kc9mne/esp32-Wi-F0X/hardware/renders/angle.png

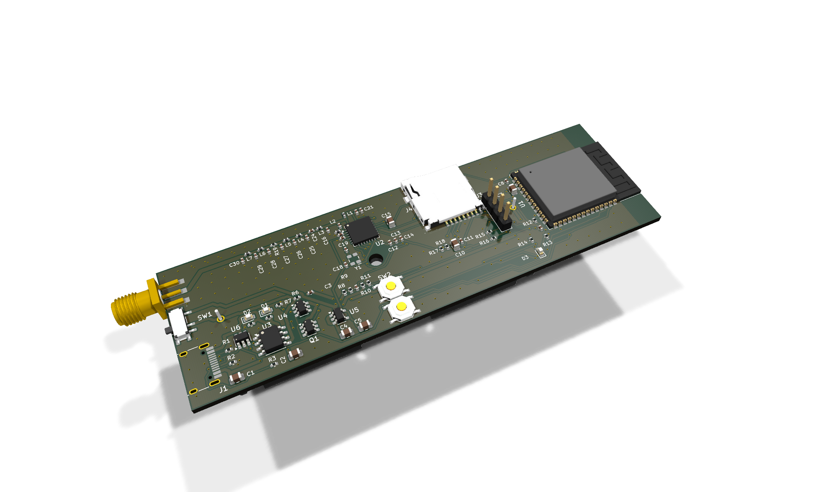
hardware/renders/angle.png
