kc9mne/esp32-Wi-F0X/hardware/renders/bottom.png

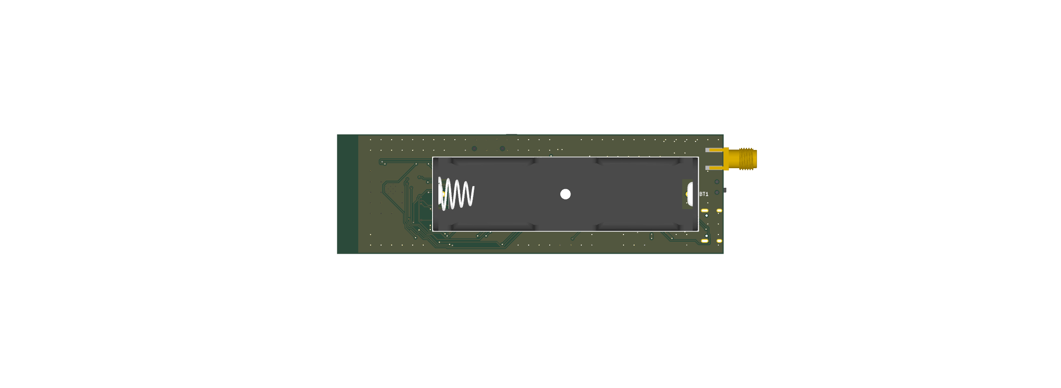
hardware/renders/bottom.png
