kc9mne/esp32-Wi-F0X/hardware/renders/copper.png

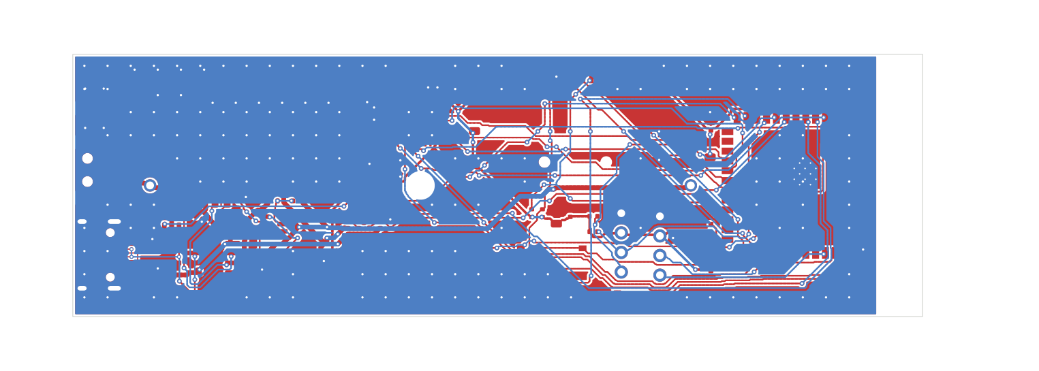
hardware/renders/copper.png
