kc9mne/esp32-Wi-F0X/hardware/renders/top.png

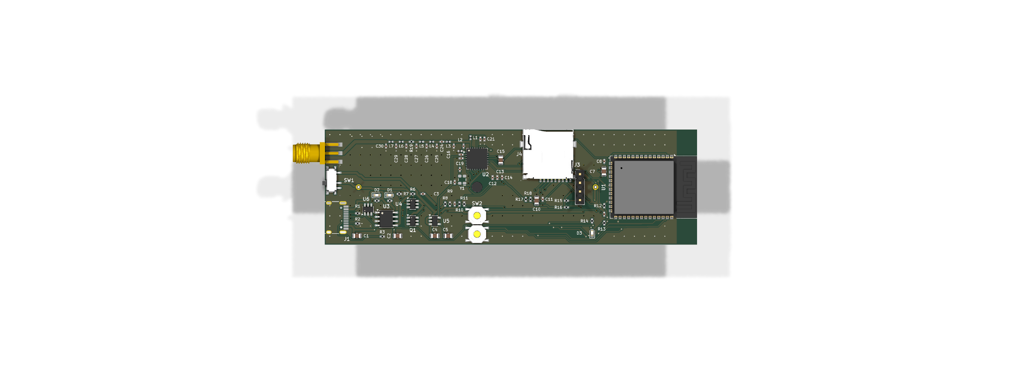
hardware/renders/top.png
