kc9mne/esp32-Wi-F0X/hardware/fox_bom_jlc.csv

Comment | Designator | Footprint | LCSC Part #
18650 | BT1 | BAT-TH_BH-18650-A1AJ005 | C49118395
10uF | C1,C2,C4,C5,C10,C15 | C_0805_2012Metric | C15850
10nF | C19,C21 | C_0402_1005Metric | C15195
270pF | C20,C24 | C_0402_1005Metric | C161546
18pF | C22 | C_0402_1005Metric | C1549
6.8pF | C23 | C_0402_1005Metric | C1576
39pF | C25,C26,C29 | C_0402_1005Metric | C1864552
9.1pF | C27 | C_0402_1005Metric | C64366
22pF | C28,C30 | C_0402_1005Metric | C1555
100nF | C3,C6,C8,C11,C12,C13,C14,C16,C17,C18 | C_0402_1005Metric | C1525
22uF | C7 | C_0805_2012Metric | C45783
1uF | C9 | C_0402_1005Metric | C52923
green: charged | D1 | LED_0603_1608Metric | C965804
red: charging | D2 | LED_0603_1608Metric | C2286
blue: status | D3 | LED_0603_1608Metric | C965807
USB-C | J1 | USB_C_Receptacle_HRO_TYPE-C-31-M-12 | C165948
microSD | J4 | TF-SMD_TF-01A | C91145
120nH | L1 | L_0402_1005Metric | C113123
91nH | L2 | L_0402_1005Metric | C113121
68nH | L3,L6,L7 | L_0402_1005Metric | C108965
56nH | L4 | L_0402_1005Metric | C167482
39nH | L5 | L_0402_1005Metric | C98059
FS8205A | Q1 | SOT-23-6 | C2830320
5.1k | R1,R2 | R_0402_1005Metric | C25905
10k | R12,R13,R17,R18 | R_0402_1005Metric | C25744
4.7k | R15,R16 | R_0402_1005Metric | C25900
0 | R19 | R_0402_1005Metric | C17168
2.4k | R3 | R_0402_1005Metric | C25882
1k | R4,R5,R7,R14 | R_0402_1005Metric | C11702
100 | R6 | R_0402_1005Metric | C25076
100k | R8,R9,R10,R11 | R_0402_1005Metric | C25741
POWER | SW1 | SW-TH_MSK12C02 | C431540
RESET/BOOT | SW2,SW3 | SW-SMD_4P-L5.1-W5.1-P3.70-LS6.5-TL_H1.5 | C318884
ESP32-S3-WROOM-1-N8 | U1 | ESP32-S3-WROOM-1 | C2913198
SX1278IMLTRT | U2 | QFN-28-1EP_6x6mm_P0.65mm_EP4.8x4.8mm | C67678
TP4056 | U3 | SOIC-8-1EP_3.9x4.9mm_P1.27mm_EP2.29x3mm | C16581
DW01A | U4 | SOT-23-6 | C351410
ME6211C33 | U5 | SOT-23-5 | C82942
USBLC6-2SC6 | U6 | SOT-23-6 | C7519
TG2520SMN 32MHz | Y1 | Oscillator_SMD_SeikoEpson_TG2520SMN-xxx-xxxxxx-4Pin_2.5x2.0mm | C3007516
