kc9mne/esp32-Wi-F0X/hardware/fox.pdf

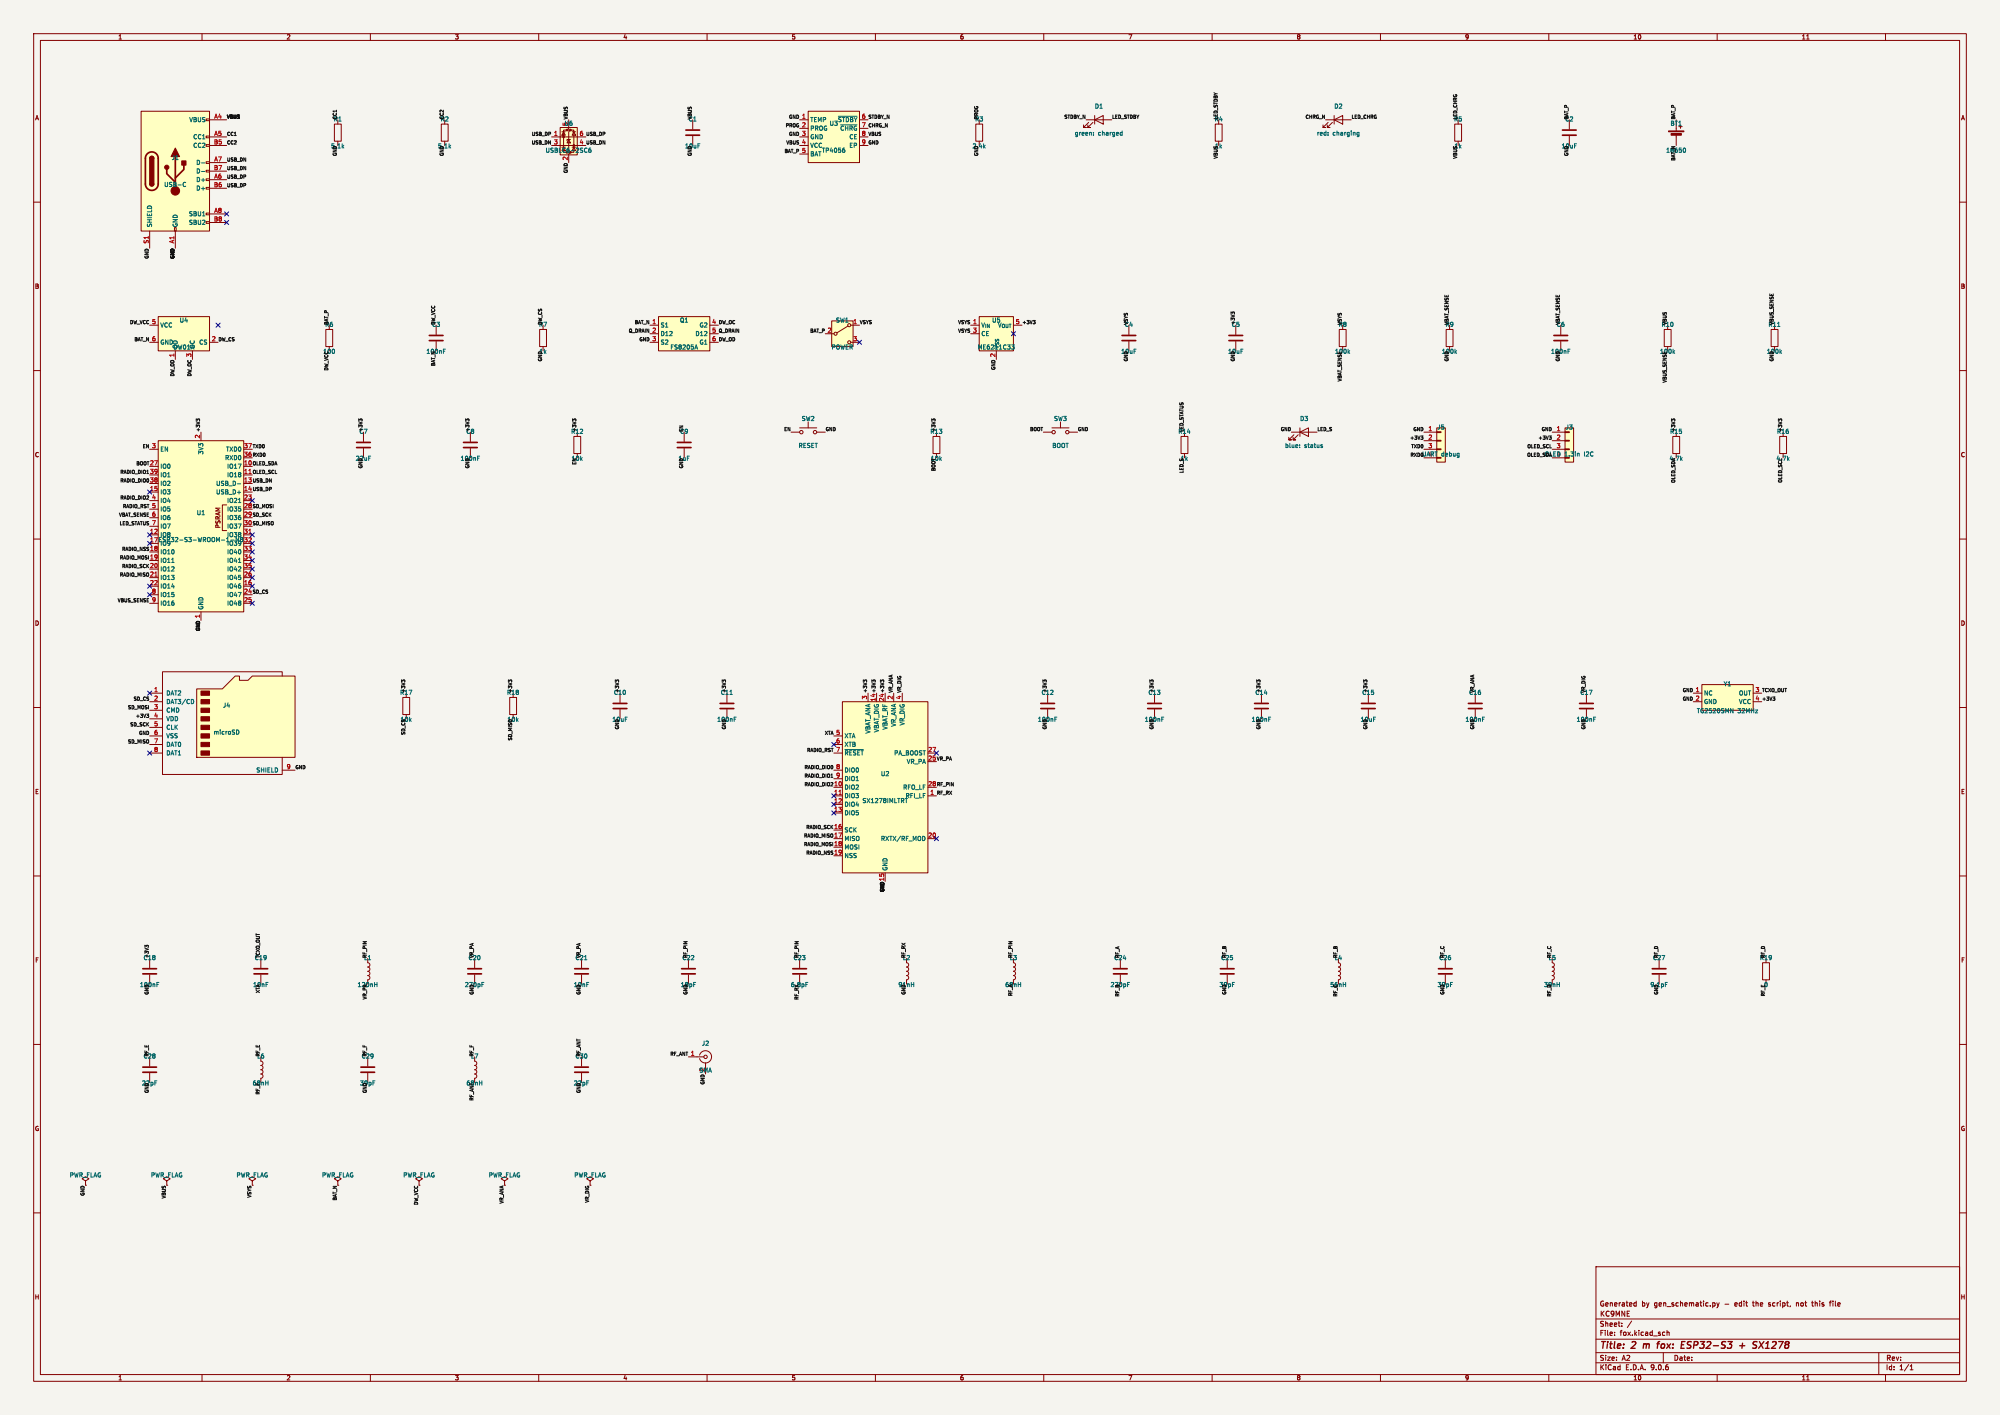
[picture p6: page 1]
