kc9mne/esp32-Wi-F0X/hardware/fox.kicad_pcb

## KiCad design hardware/fox.kicad_pcb (2026-11-11)

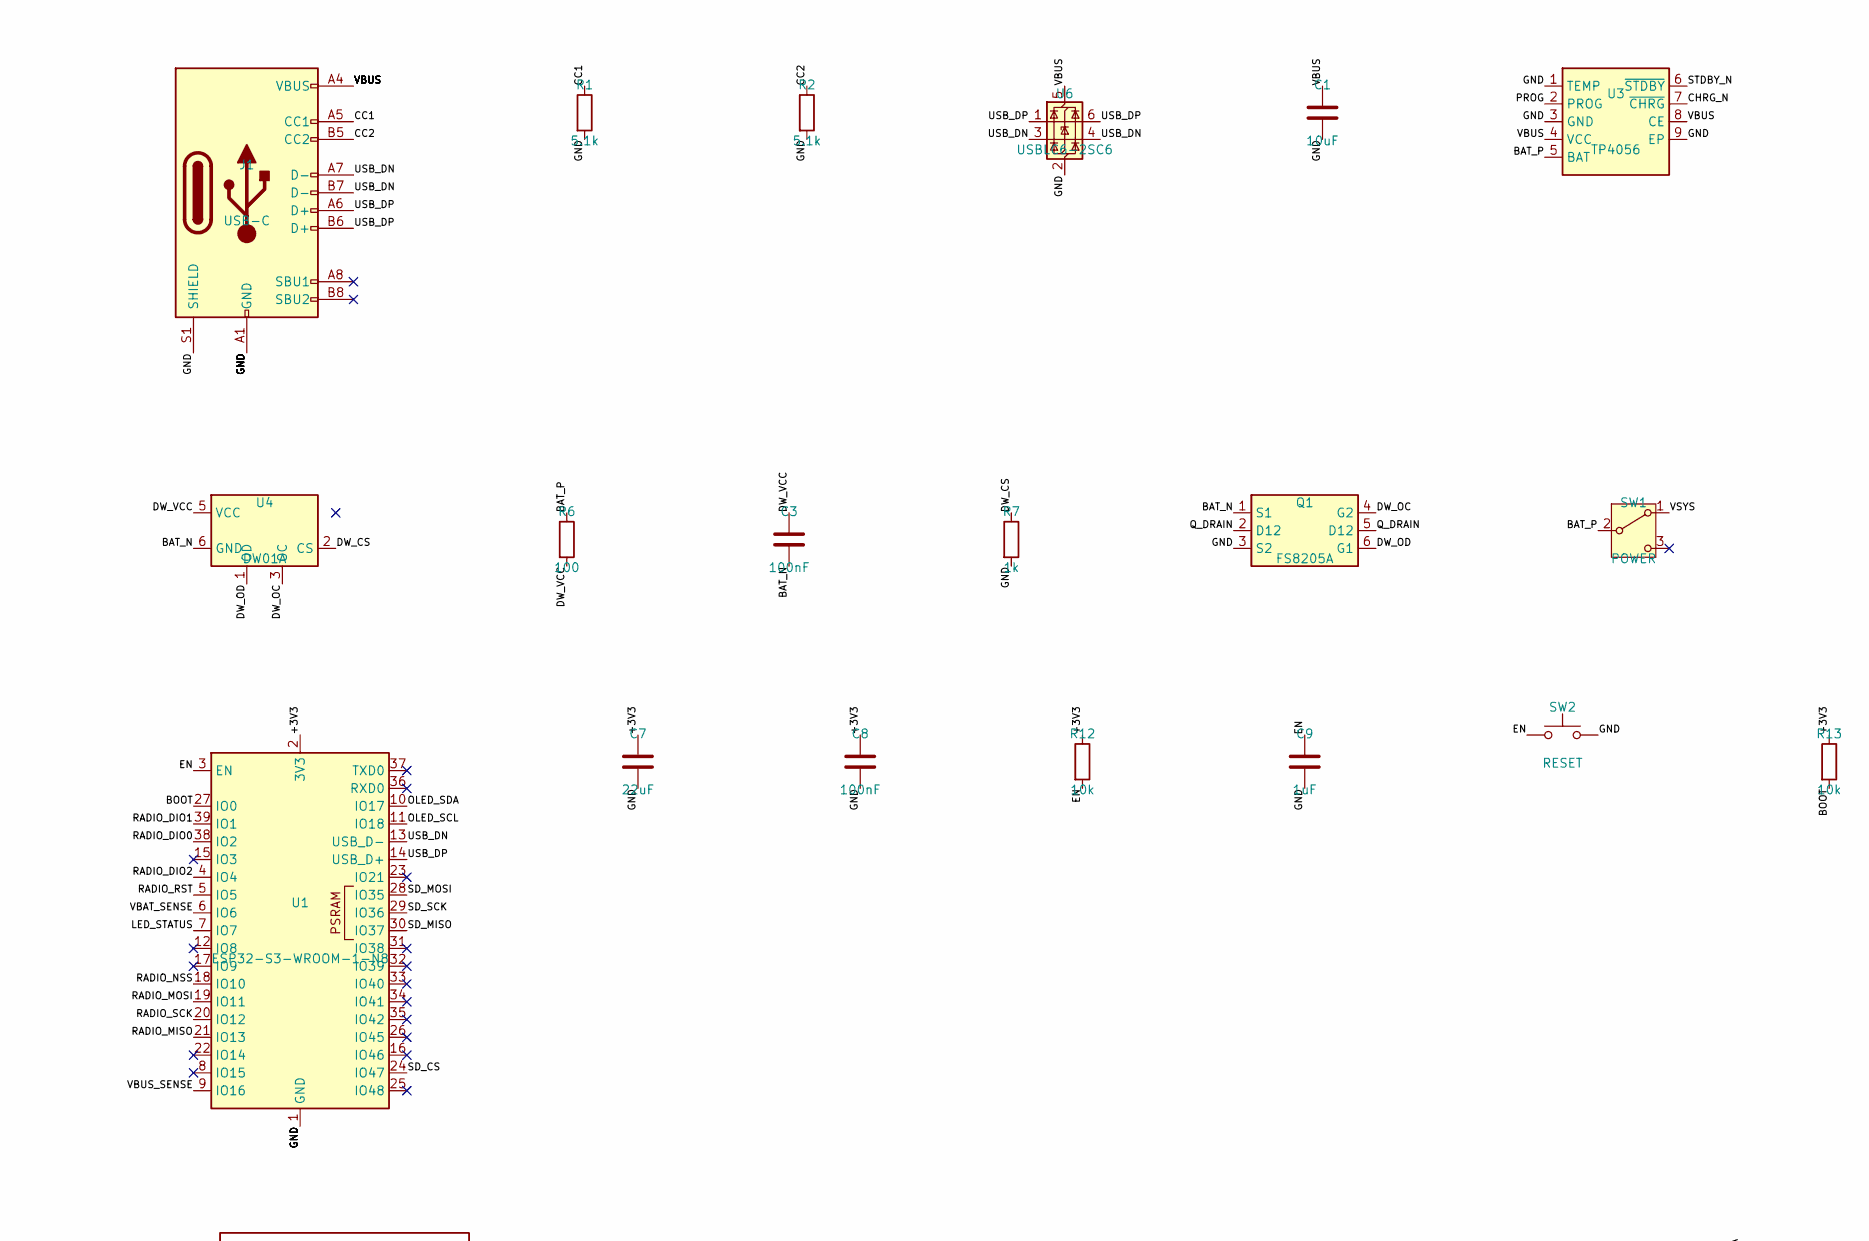
[picture p7: schematic fox.kicad_sch, 2 m fox: ESP32-S3 + SX1278, part in row 1, column 1]

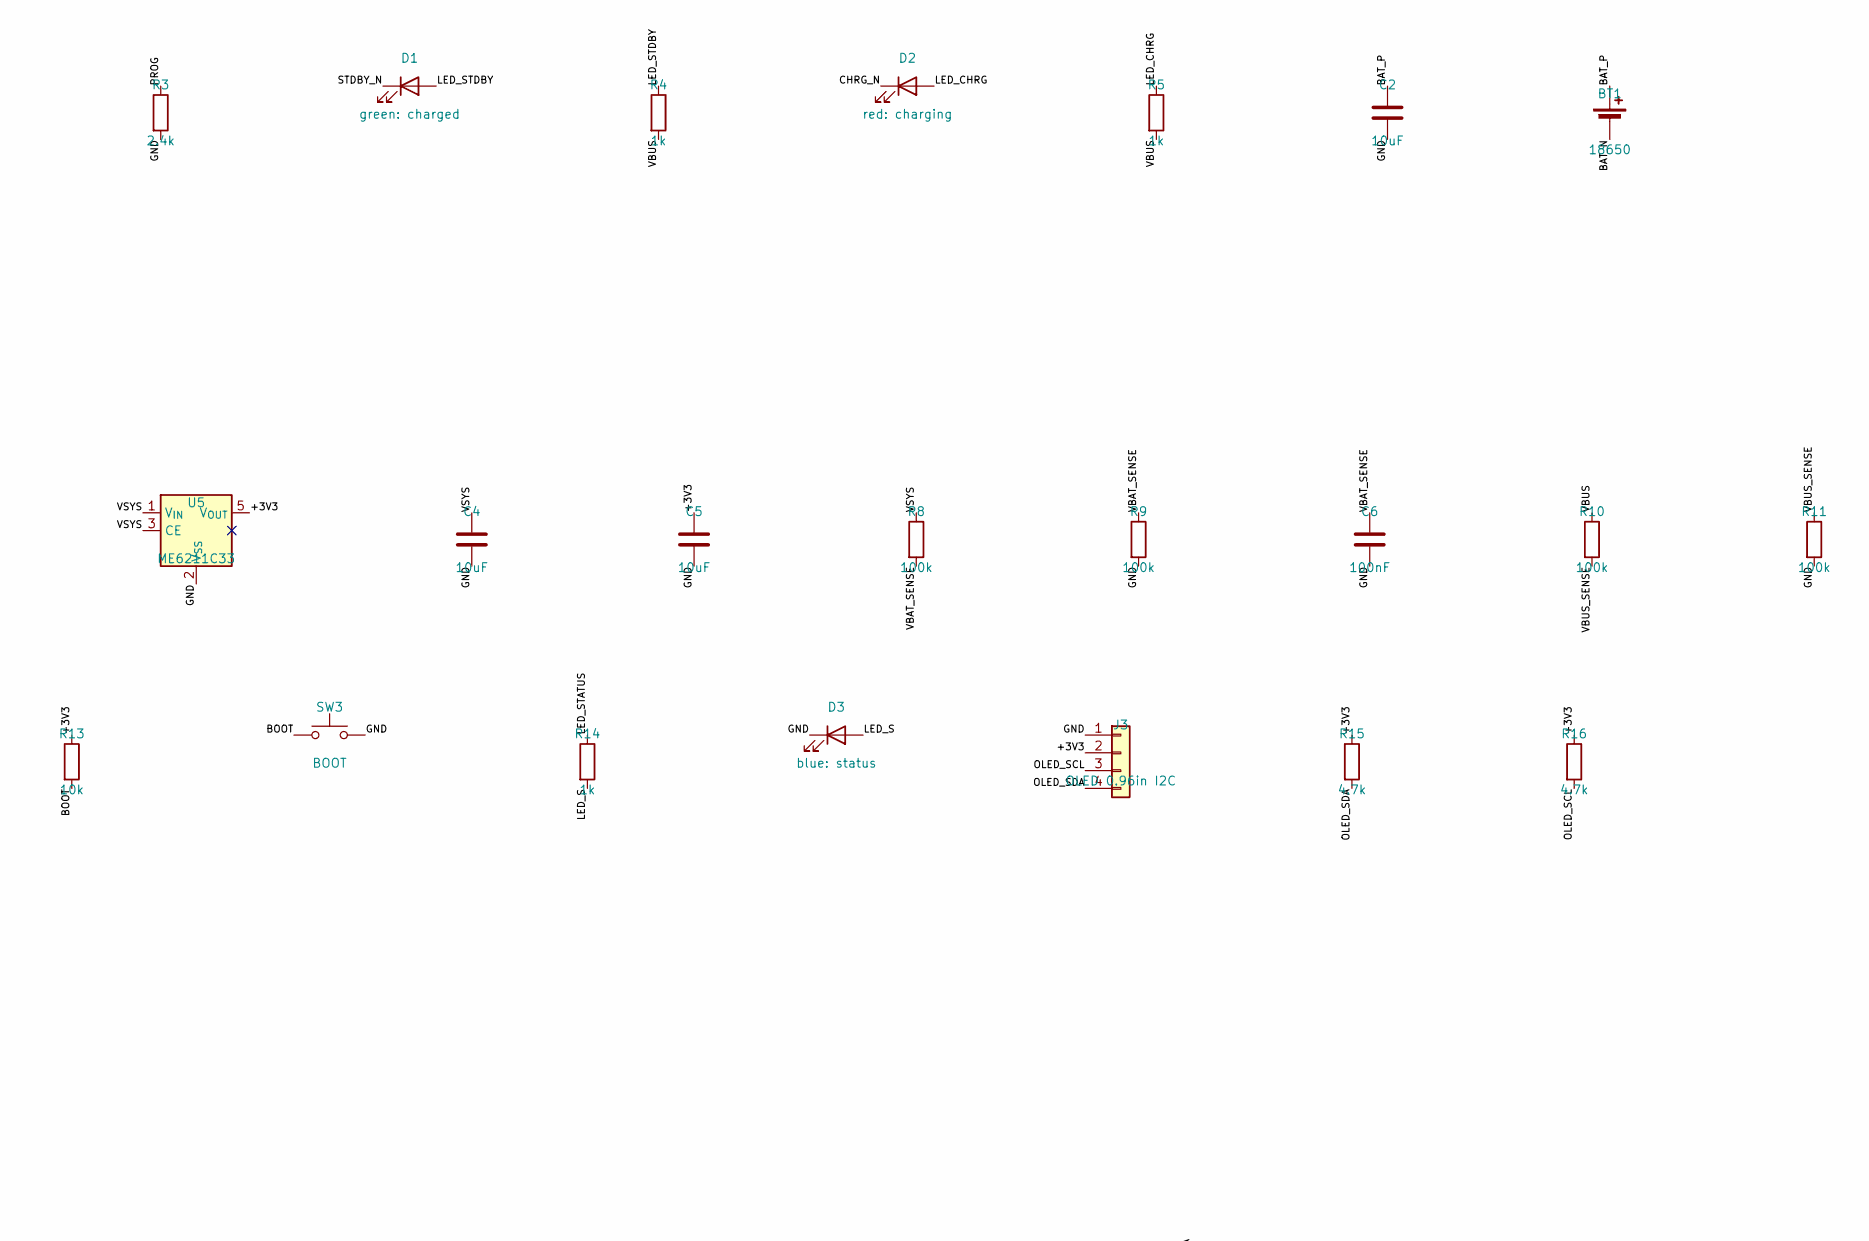
[picture p8: schematic fox.kicad_sch, 2 m fox: ESP32-S3 + SX1278, part in row 1, column 2]

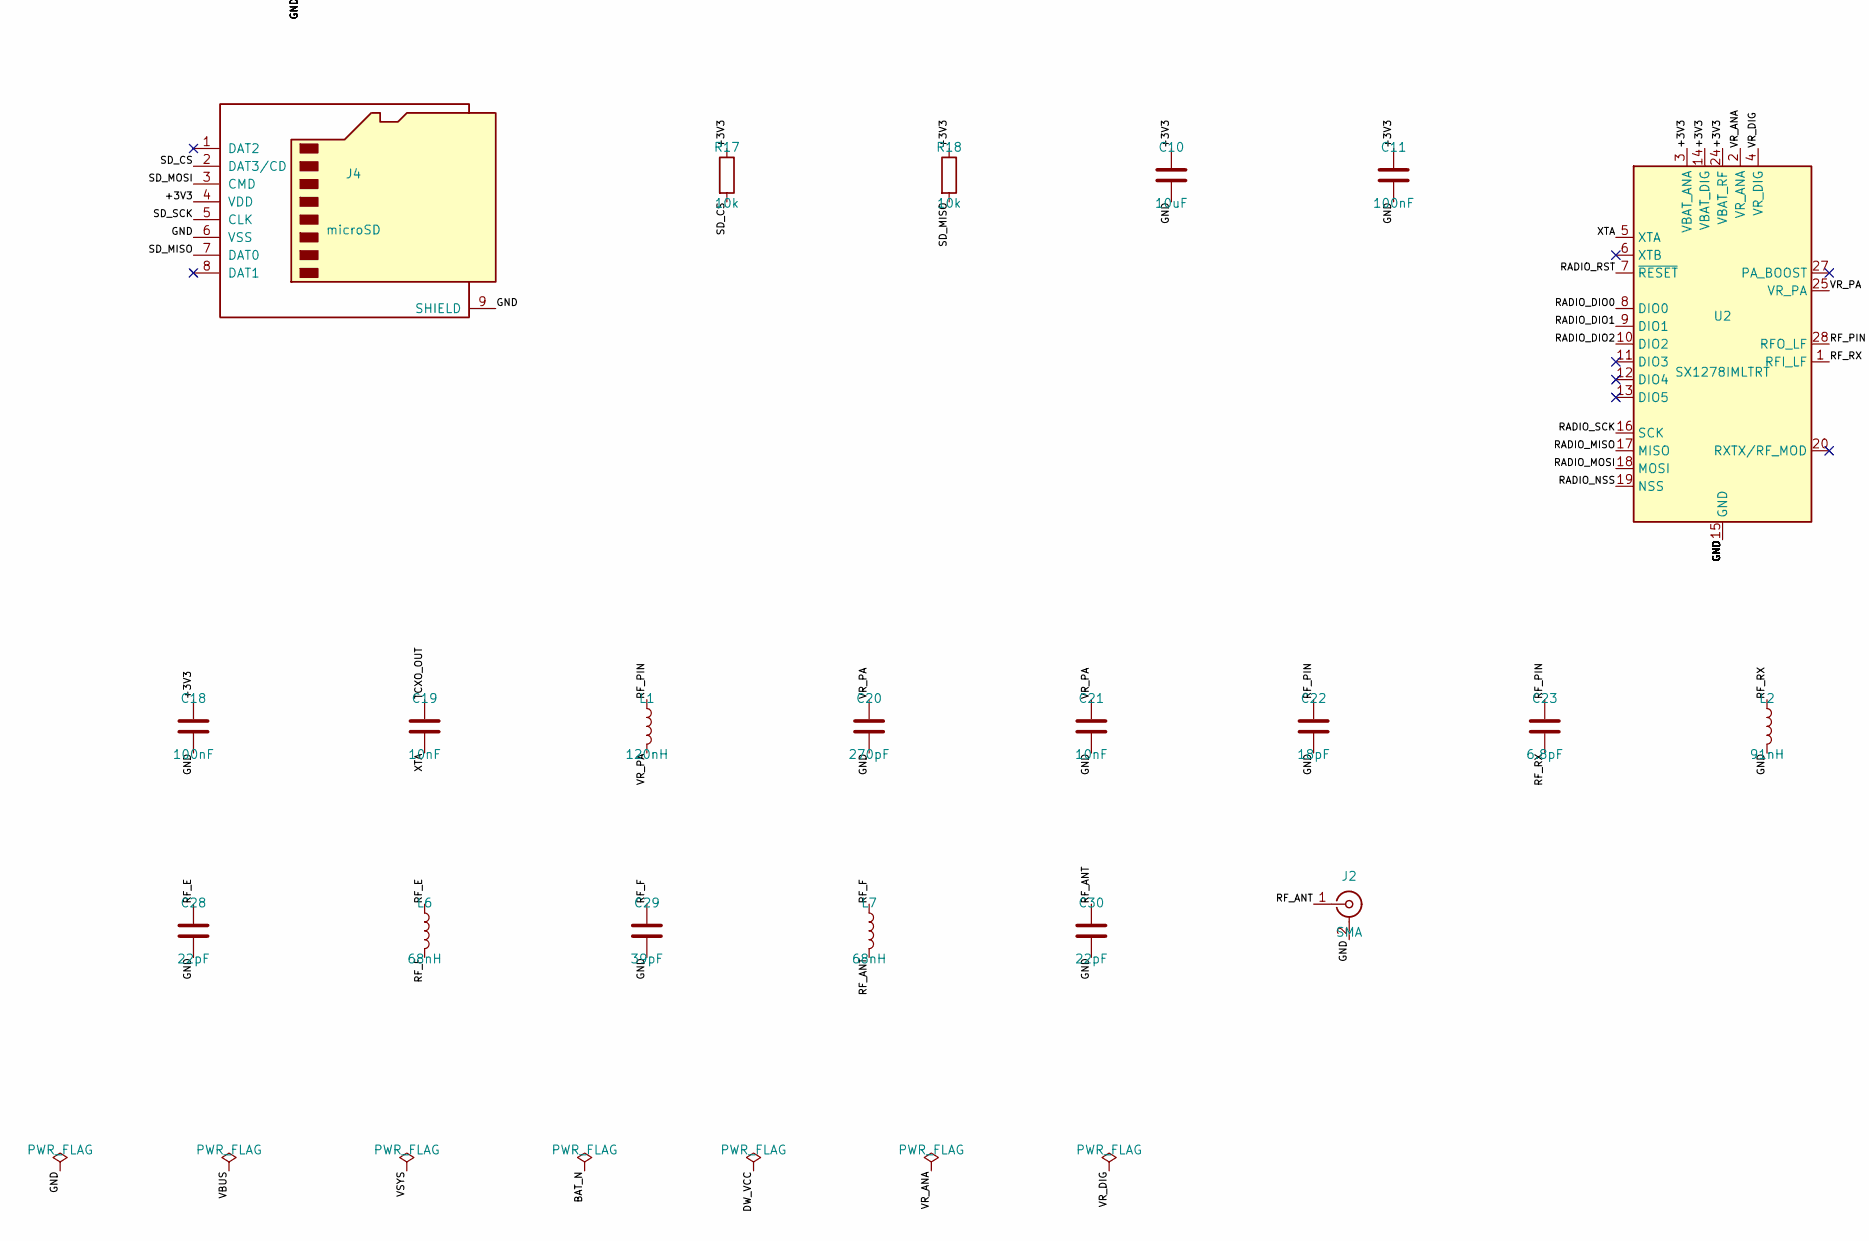
[picture p9: schematic fox.kicad_sch, 2 m fox: ESP32-S3 + SX1278, part in row 2, column 1]

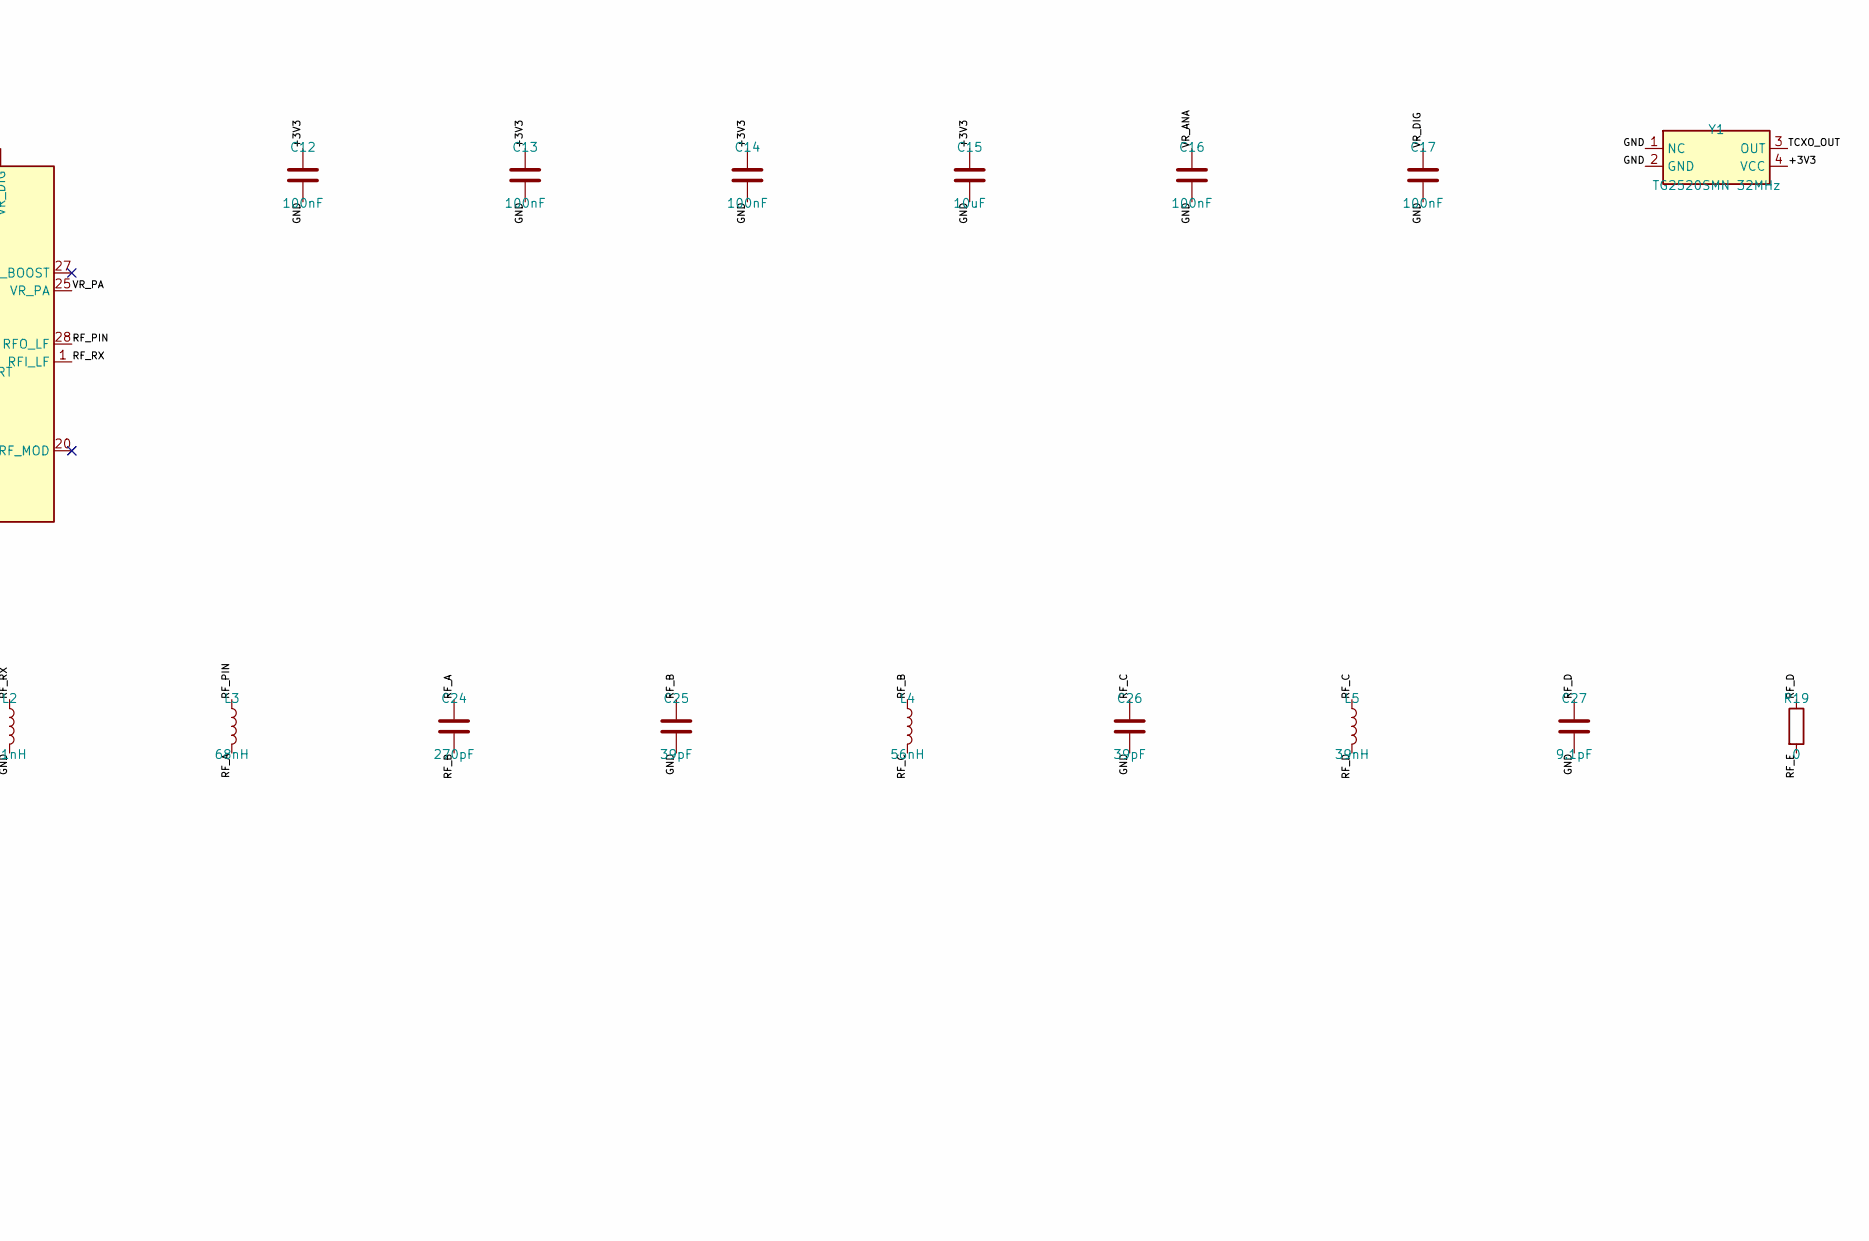
[picture p10: schematic fox.kicad_sch, 2 m fox: ESP32-S3 + SX1278, part in row 2, column 2]

Parts:
BT1: 18650; BAT-TH_BH-18650-A1AJ005; LCSC C49118395
C1, C2, C4, C5, C10, C15: 10uF; C_0805_2012Metric; LCSC C15850
C3, C6, C8, C11, C12, C13, C14, C16, C17, C18: 100nF; C_0402_1005Metric; LCSC C1525
C7: 22uF; C_0805_2012Metric; LCSC C45783
C9: 1uF; C_0402_1005Metric; LCSC C52923
C19, C21: 10nF; C_0402_1005Metric; LCSC C15195
C20, C24: 270pF; C_0402_1005Metric; LCSC C161546
C22: 18pF; C_0402_1005Metric; LCSC C1549
C23: 6.8pF; C_0402_1005Metric; LCSC C1576
C25, C26, C29: 39pF; C_0402_1005Metric; LCSC C1864552
C27: 9.1pF; C_0402_1005Metric; LCSC C64366
C28, C30: 22pF; C_0402_1005Metric; LCSC C1555
D1: green: charged; LED_0603_1608Metric; LCSC C965804
D2: red: charging; LED_0603_1608Metric; LCSC C2286
D3: blue: status; LED_0603_1608Metric; LCSC C965807
J1: USB-C; USB_C_Receptacle_HRO_TYPE-C-31-M-12; LCSC C165948
J2: SMA; SMA-SMD_BWSMA-KE-P001; LCSC C496550
J3: OLED 0.96in I2C; PinHeader_1x04_P2.54mm_Vertical
J4: microSD; TF-SMD_TF-01A; LCSC C91145
L1: 120nH; L_0402_1005Metric; LCSC C113123
L2: 91nH; L_0402_1005Metric; LCSC C113121
L3, L6, L7: 68nH; L_0402_1005Metric; LCSC C108965
L4: 56nH; L_0402_1005Metric; LCSC C167482
L5: 39nH; L_0402_1005Metric; LCSC C98059
Q1: FS8205A; SOT-23-6; LCSC C2830320
R1, R2: 5.1k; R_0402_1005Metric; LCSC C25905
R3: 2.4k; R_0402_1005Metric; LCSC C25882
R4, R5, R7, R14: 1k; R_0402_1005Metric; LCSC C11702
R6: 100; R_0402_1005Metric; LCSC C25076
R8, R9, R10, R11: 100k; R_0402_1005Metric; LCSC C25741
R12, R13, R17, R18: 10k; R_0402_1005Metric; LCSC C25744
R15, R16: 4.7k; R_0402_1005Metric; LCSC C25900
R19: 0; R_0402_1005Metric; LCSC C17168
SW1: POWER; SW-TH_MSK12C02; LCSC C431540
SW2: RESET; SW-SMD_4P-L5.1-W5.1-P3.70-LS6.5-TL_H1.5; LCSC C318884
SW3: BOOT; SW-SMD_4P-L5.1-W5.1-P3.70-LS6.5-TL_H1.5; LCSC C318884
U1: ESP32-S3-WROOM-1-N8; ESP32-S3-WROOM-1; LCSC C2913198
U2: SX1278IMLTRT; QFN-28-1EP_6x6mm_P0.65mm_EP4.8x4.8mm; LCSC C67678
U3: TP4056; SOIC-8-1EP_3.9x4.9mm_P1.27mm_EP2.29x3mm; LCSC C16581
U4: DW01A; SOT-23-6; LCSC C351410
U5: ME6211C33; SOT-23-5; LCSC C82942
U6: USBLC6-2SC6; SOT-23-6; LCSC C7519
Y1: TG2520SMN 32MHz; Oscillator_SMD_SeikoEpson_TG2520SMN-xxx-xxxxxx-4Pin_2.5x2.0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; LCSC C3007516

Connections:
/+3V3: C5.1, C7.1, C8.1, C10.1, C11.1, C12.1, C13.1, C14.1, C15.1, C18.1, J3.2, J4.4 (VDD), R12.1, R13.1, R15.1, R16.1, R17.1, R18.1, U1.2 (3V3), U2.3 (VBAT_ANA), U2.14 (VBAT_DIG), U2.24 (VBAT_RF), U5.5 (V_{OUT}), Y1.4 (VCC)
/BAT_N: BT1.2 (-), C3.2, Q1.1 (S1), U4.6 (GND)
/BAT_P: BT1.1 (+), C2.1, R6.1, SW1.2 (B), U3.5 (BAT)
/BOOT: R13.2, SW3.1, U1.27 (IO0)
/CC1: J1.A5 (CC1), R1.1
/CC2: J1.B5 (CC2), R2.1
/CHRG_N: D2.1 (K), U3.7 (~CHRG)
/DW_CS: R7.1, U4.2 (CS)
/DW_OC: Q1.4 (G2), U4.3 (OC)
/DW_OD: Q1.6 (G1), U4.1 (OD)
/DW_VCC: C3.1, R6.2, U4.5 (VCC)
/EN: C9.1, R12.2, SW2.1, U1.3 (EN)
/GND: C1.2, C2.2, C4.2, C5.2, C6.2, C7.2, C8.2, C9.2, C10.2, C11.2, C12.2, C13.2, C14.2, C15.2, C16.2, C17.2, C18.2, C20.2, C21.2, C22.2, C25.2, C26.2, C27.2, C28.2, C29.2, C30.2, D3.1 (K), J1.A1 (GND), J1.A12 (GND), J1.B1 (GND), J1.B12 (GND), J1.S1 (SHIELD), J2.2 (Ext), J3.1, J4.6 (VSS), J4.9 (SHIELD), L2.2, Q1.3 (S2), R1.2, R2.2, R3.2, R7.2, R9.2, R11.2, SW2.2, SW3.2, U1.1 (GND), U1.40 (GND), U1.41 (GND), U2.15 (GND), U2.21 (GND), U2.22 (GND), U2.23 (GND), U2.26 (GND), U2.29 (GND), U3.1 (TEMP), U3.3 (GND), U3.9 (EP), U5.2 (V_{SS}), U6.2 (GND), Y1.1 (NC), Y1.2 (GND)
/LED_CHRG: D2.2 (A), R5.1
/LED_S: D3.2 (A), R14.2
/LED_STATUS: R14.1, U1.7 (IO7)
/LED_STDBY: D1.2 (A), R4.1
/OLED_SCL: J3.3, R16.2, U1.11 (IO18)
/OLED_SDA: J3.4, R15.2, U1.10 (IO17)
/PROG: R3.1, U3.2 (PROG)
/Q_DRAIN: Q1.2 (D12), Q1.5 (D12)
/RADIO_DIO0: U1.38 (IO2), U2.8 (DIO0)
/RADIO_DIO1: U1.39 (IO1), U2.9 (DIO1)
/RADIO_DIO2: U1.4 (IO4), U2.10 (DIO2)
/RADIO_MISO: U1.21 (IO13), U2.17 (MISO)
/RADIO_MOSI: U1.19 (IO11), U2.18 (MOSI)
/RADIO_NSS: U1.18 (IO10), U2.19 (NSS)
/RADIO_RST: U1.5 (IO5), U2.7 (~RESET)
/RADIO_SCK: U1.20 (IO12), U2.16 (SCK)
/RF_A: C24.1, L3.2
/RF_ANT: C30.1, J2.1 (In), L7.2
/RF_B: C24.2, C25.1, L4.1
/RF_C: C26.1, L4.2, L5.1
/RF_D: C27.1, L5.2, R19.1
/RF_E: C28.1, L6.1, R19.2
/RF_F: C29.1, L6.2, L7.1
/RF_PIN: C22.1, C23.1, L1.1, L3.1, U2.28 (RFO_LF)
/RF_RX: C23.2, L2.1, U2.1 (RFI_LF)
/SD_CS: J4.2 (DAT3/CD), R17.2, U1.24 (IO47)
/SD_MISO: J4.7 (DAT0), R18.2, U1.30 (IO37)
/SD_MOSI: J4.3 (CMD), U1.28 (IO35)
/SD_SCK: J4.5 (CLK), U1.29 (IO36)
/STDBY_N: D1.1 (K), U3.6 (~STDBY)
/TCXO_OUT: C19.1, Y1.3 (OUT)
/USB_DN: J1.A7 (D-), J1.B7 (D-), U1.13 (USB_D-), U6.3 (I/O2), U6.4 (I/O2)
/USB_DP: J1.A6 (D+), J1.B6 (D+), U1.14 (USB_D+), U6.1 (I/O1), U6.6 (I/O1)
/VBAT_SENSE: C6.1, R8.2, R9.1, U1.6 (IO6)
/VBUS: C1.1, J1.A4 (VBUS), J1.A9 (VBUS), J1.B4 (VBUS), J1.B9 (VBUS), R4.2, R5.2, R10.1, U3.4 (VCC), U3.8 (CE), U6.5 (VBUS)
/VBUS_SENSE: R10.2, R11.1, U1.9 (IO16)
/VR_ANA: C16.1, U2.2 (VR_ANA)
/VR_DIG: C17.1, U2.4 (VR_DIG)
/VR_PA: C20.1, C21.1, L1.2, U2.25 (VR_PA)
/VSYS: C4.1, R8.1, SW1.1 (A), U5.1 (V_{IN}), U5.3 (CE)
/XTA: C19.2, U2.5 (XTA)

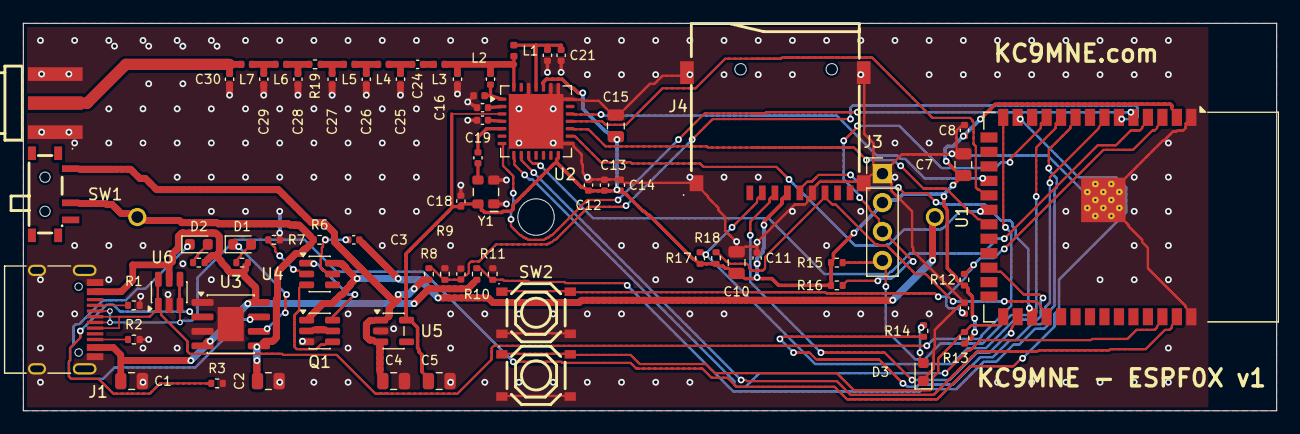
[picture p11: board fox.kicad_pcb from above]

Board: 2 copper layers, 110.0 x 34.0 mm, 75 parts (1 on the bottom side), 54 nets.
