kc9mne/esp32-Wi-F0X/(commit log)

2026-11-11 Wi-F0X: 2 m fox-hunt beacon for the T-Beam Supreme 144
    Firmware for the LilyGO T-Beam Supreme 144-148 MHz: tone, Morse and CW ID
    cycle, ARDF MO and MicroFox 50 tracking modes, SD voice clips sent as FM by
    per-sample retuning, and a phone settings page over the fox's own Wi-Fi.
    Adds the KC9MNE Wi-F0X boot screen and web header, a random per-fox Wi-Fi
    password (the old one was derivable from the SSID), and an N0CALL default
    callsign. Includes the experimental custom board in hardware/.
    [fox-B_Cu.gbr, fox-B_Mask.gbr, fox-B_Paste.gbr, fox-B_Silkscreen.gbr, fox-Edge_Cuts.gbr, fox-F_Cu.gbr, fox-F_Mask.gbr, fox-F_Paste.gbr]
2026-11-11 Wi-Fi QR code on the OLED, easier password, framed 3 s splash
    The Wi-Fi password is now two letters and six digits, and an older stored
    password is replaced on the next boot. Until a phone joins, the OLED
    alternates the status screen with a QR code that joins the fox's network.
    The boot screen gets a border and stays up for 3 s.
    [main.cpp]
2026-11-11 README: enclosure parts, photo and demo video
    Adds a photo of the fox in its clear polycarbonate tube with rubber end
    caps, the tube and cap details, and a 41 s bench demo (voice and tones)
    re-encoded to 720p H.264 so browsers can play it.
2026-11-11 README: demo video on YouTube, label the tube and cap links
    GitHub won't preview the MP4, so the demo thumbnail now opens the YouTube
    upload and the repo copy is dropped.
